PositiveAltitude/BLDC-servo-v1-hardware/bldc_servo_v1.kicad_pcb

## KiCad design bldc_servo_v1.kicad_pcb (2025-04-05)

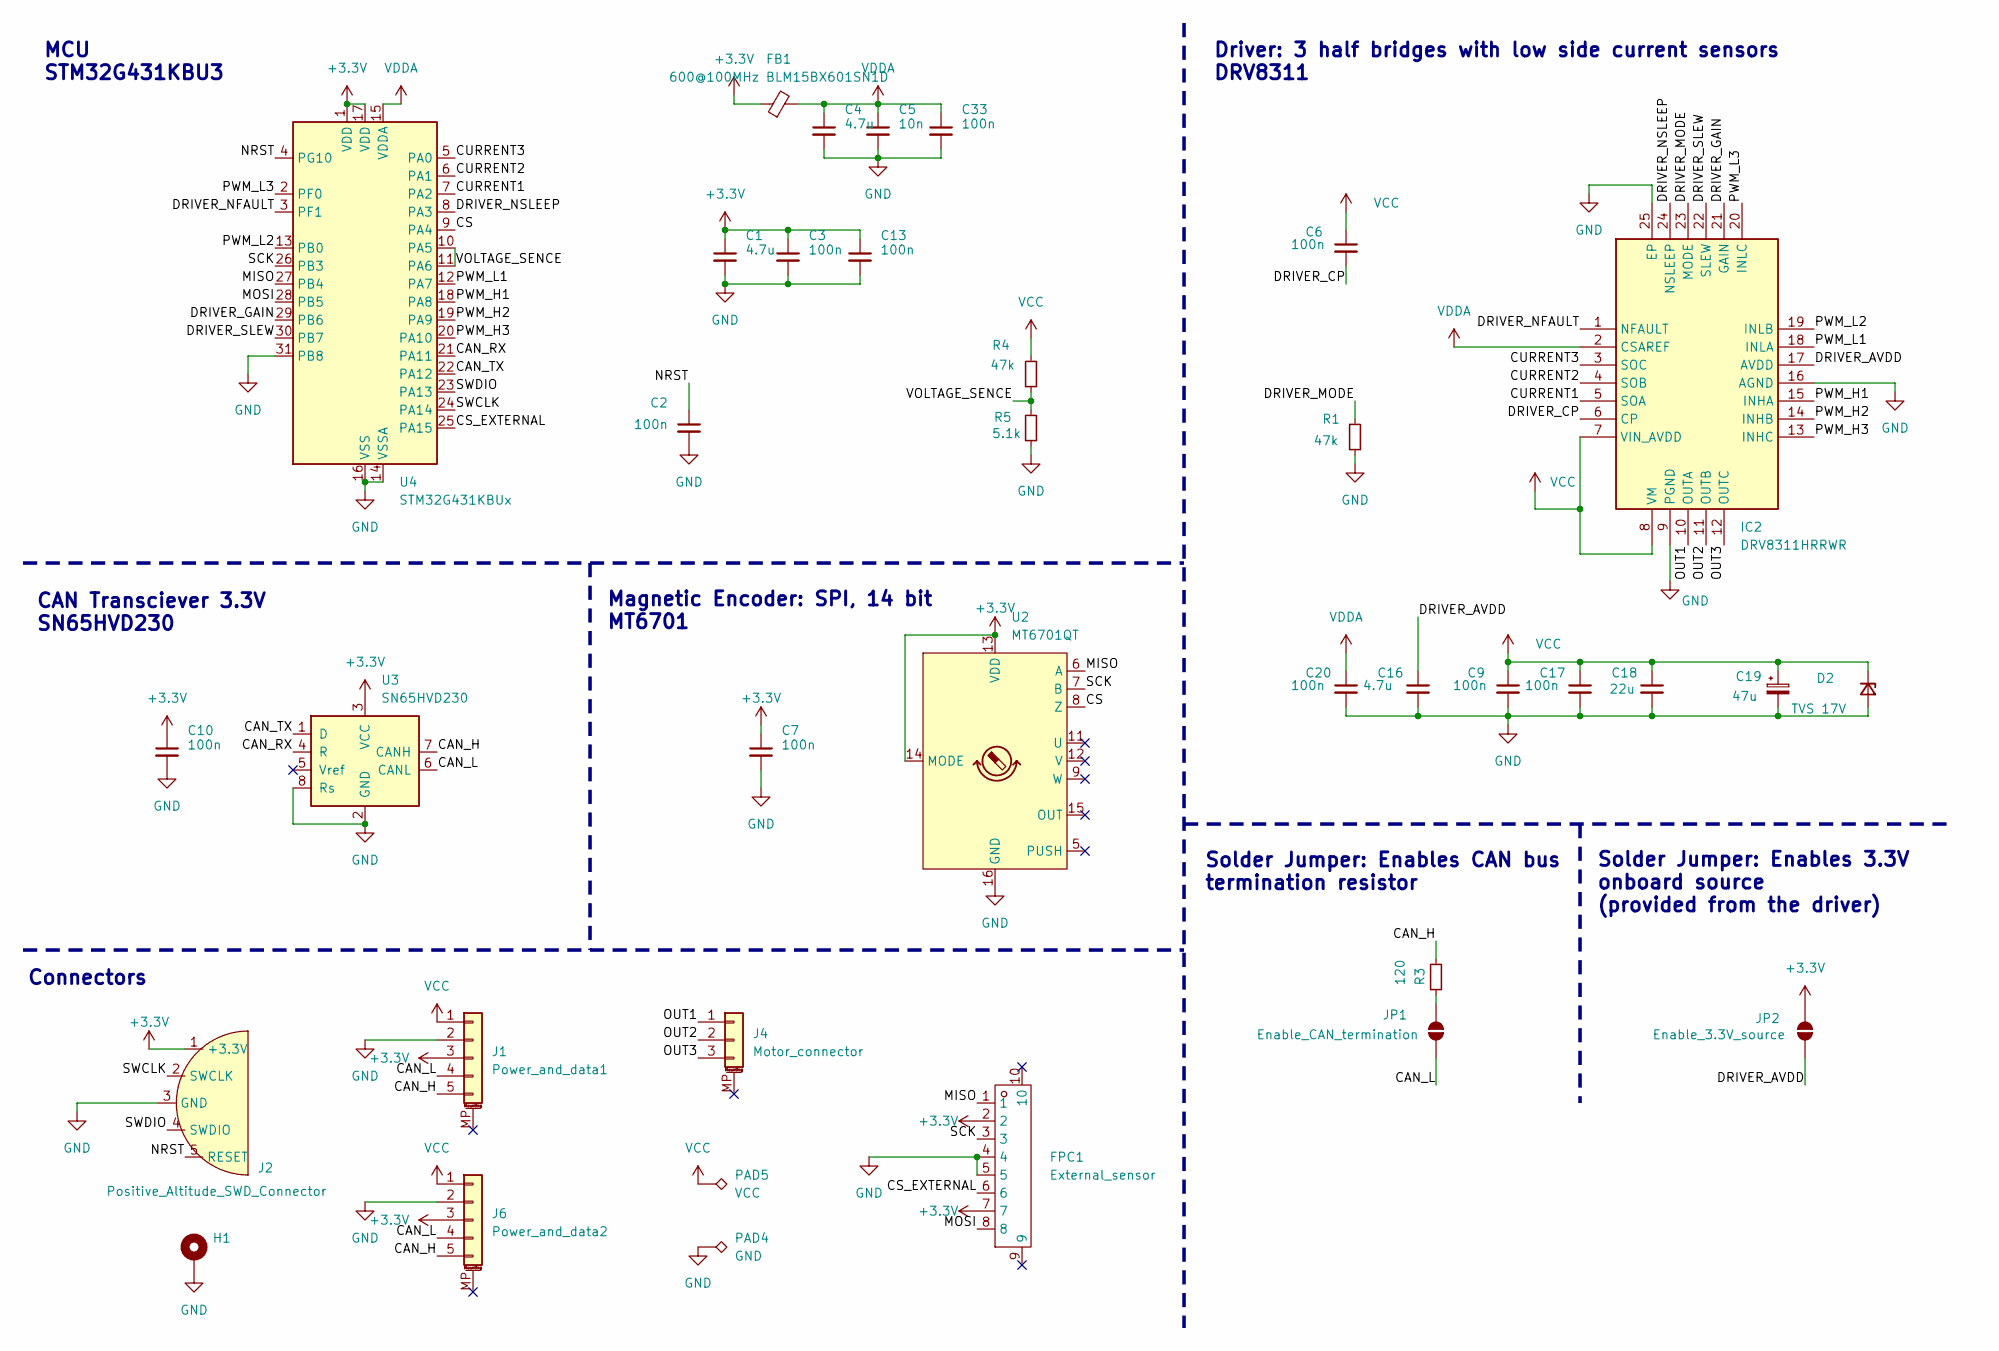
[picture p1: schematic bldc_servo_v1.kicad_sch]

Parts:
C1, C4, C16: 4.7u; C_0603_1608Metric_Pad1.08x0.95mm_HandSolder; LCSC C162274
C2, C3, C6, C7, C9, C10, C13, C17, C20, C33: 100n; C_0402_1005Metric_Pad0.74x0.62mm_HandSolder; LCSC C77020
C5: 10n; C_0402_1005Metric_Pad0.74x0.62mm_HandSolder; LCSC C77019
C18: 22u; C_1210_3225Metric_Pad1.33x2.70mm_HandSolder; LCSC C21397
C19: 47u; CP_Elec_6.3x5.8; LCSC C2161781
D2: TVS 17V; D_SOD-123F; LCSC C353303
FB1: 600@100MHz BLM15BX601SN1D; R_0402_1005Metric_Pad0.72x0.64mm_HandSolder; LCSC C710336
FPC1: External_sensor; FPC-SMD_8P-P0.50_HC-FPC-05-09-8RLTAG; Manufacturer Part HC-FPC-05-09-8RLTAG; LCSC Part Name 翻盖式 双侧触点/上下接 P数:8P 间距:0.5mm
H1: MountingHole_Pad; MountingHole_2.2mm_M2_Pad_TopBottom
IC2: DRV8311HRRWR; DRV8311PRRWR; Mouser Part Number 595-DRV8311HRRWR
J1: Power_and_data1; JST_SH_SM05B-SRSS-TB_1x05-1MP_P1.00mm_Horizontal; LCSC C136657
J2: Positive_Altitude_SWD_Connector
J4: Motor_connector; JST_PH_S3B-PH-SM4-TB_1x03-1MP_P2.00mm_Horizontal; LCSC C265101
J6: Power_and_data2; JST_SH_SM05B-SRSS-TB_1x05-1MP_P1.00mm_Horizontal; LCSC C136657
JP1: Enable_CAN_termination; SolderJumper-2_P1.3mm_Open_RoundedPad1.0x1.5mm
JP2: Enable_3.3V_source; SolderJumper-2_P1.3mm_Open_RoundedPad1.0x1.5mm
PAD4: GND; TestPoint_Pad_1.5x1.5mm
PAD5: VCC; TestPoint_Pad_1.5x1.5mm
R1, R4: 47k; R_0402_1005Metric_Pad0.72x0.64mm_HandSolder; LCSC C93943
R3: 120; R_0402_1005Metric_Pad0.72x0.64mm_HandSolder; LCSC C114758
R5: 5.1k; R_0402_1005Metric_Pad0.72x0.64mm_HandSolder; LCSC C105872
U2: MT6701QT; QFN-16-1EP_3x3mm_P0.5mm_EP1.7x1.7mm; LCSC C2913974
U3: SN65HVD230; SOIC-8_3.9x4.9mm_P1.27mm; LCSC C12084
U4: STM32G431KBUx; QFN-32-1EP_5x5mm_P0.5mm_EP3.45x3.45mm; LCSC C1341901

Connections:
+3.3V: C1.1, C3.1, C7.1, C10.1, C13.1, FB1.1, FPC1.2, FPC1.7, J1.3, J2.1 (+3.3V), J6.3, JP2.2 (B), U2.13 (VDD), U2.14 (MODE), U3.3 (VCC), U4.1 (VDD), U4.17 (VDD)
/CAN_H: J1.5, J6.5, R3.2, U3.7 (CANH)
/CAN_L: J1.4, J6.4, JP1.1 (A), U3.6 (CANL)
/CAN_RX: U3.4 (R), U4.21 (PA11)
/CAN_TX: U3.1 (D), U4.22 (PA12)
/CS: U2.8 (Z), U4.9 (PA4)
/CS_EXTERNAL: FPC1.6, U4.25 (PA15)
/CURRENT1: IC2.5 (SOA), U4.7 (PA2)
/CURRENT2: IC2.4 (SOB), U4.6 (PA1)
/CURRENT3: IC2.3 (SOC), U4.5 (PA0)
/DRIVER_AVDD: C16.1, IC2.17 (AVDD), JP2.1 (A)
/DRIVER_CP: C6.2, IC2.6 (CP)
/DRIVER_GAIN: IC2.21 (GAIN), U4.29 (PB6)
/DRIVER_MODE: IC2.23 (MODE), R1.1
/DRIVER_NFAULT: IC2.1 (NFAULT), U4.3 (PF1)
/DRIVER_NSLEEP: IC2.24 (NSLEEP), U4.8 (PA3)
/DRIVER_SLEW: IC2.22 (SLEW), U4.30 (PB7)
/MISO: FPC1.1, U2.6 (A), U4.27 (PB4)
/MOSI: FPC1.8, U4.28 (PB5)
/NRST: C2.1, J2.5 (RESET), U4.4 (PG10)
/OUT1: IC2.10 (OUTA), J4.1
/OUT2: IC2.11 (OUTB), J4.2
/OUT3: IC2.12 (OUTC), J4.3
/PWM_H1: IC2.15 (INHA), U4.18 (PA8)
/PWM_H2: IC2.14 (INHB), U4.19 (PA9)
/PWM_H3: IC2.13 (INHC), U4.20 (PA10)
/PWM_L1: IC2.18 (INLA), U4.12 (PA7)
/PWM_L2: IC2.19 (INLB), U4.13 (PB0)
/PWM_L3: IC2.20 (INLC), U4.2 (PF0)
/SCK: FPC1.3, U2.7 (B), U4.26 (PB3)
/SWCLK: J2.2 (SWCLK), U4.24 (PA14)
/SWDIO: J2.4 (SWDIO), U4.23 (PA13)
/VOLTAGE_SENCE: R4.1, R5.2, U4.10 (PA5), U4.11 (PA6)
GND: C1.2, C2.2, C3.2, C4.2, C5.2, C7.2, C9.2, C10.2, C13.2, C16.2, C17.2, C18.2, C19.2, C20.2, C33.2, D2.2 (A), FPC1.4, FPC1.5, H1.1, IC2.9 (PGND), IC2.16 (AGND), IC2.25 (EP), J1.2, J2.3 (GND), J6.2, PAD4.1, R1.2, R5.1, U2.16 (GND), U2.17 (GND), U3.2 (GND), U3.8 (Rs), U4.14 (VSSA), U4.16 (VSS), U4.31 (PB8), U4.32 (VSS), U4.33 (VSS)
unnamed: JP1.2 (B), R3.1
VCC: C6.1, C9.1, C17.1, C18.1, C19.1, D2.1 (K), IC2.7 (VIN_AVDD), IC2.8 (VM), J1.1, J6.1, PAD5.1, R4.2
VDDA: C4.1, C5.1, C20.1, C33.1, FB1.2, IC2.2 (CSAREF), U4.15 (VDDA)

Notes on the sheet:
MCU STM32G431KBU3
Solder Jumper: Enables 3.3V onboard source (provided from the driver)
Driver: 3 half bridges with low side current sensors DRV8311
Magnetic Encoder: SPI, 14 bit MT6701
CAN Transciever 3.3V SN65HVD230
Solder Jumper: Enables CAN bus termination resistor
Connectors

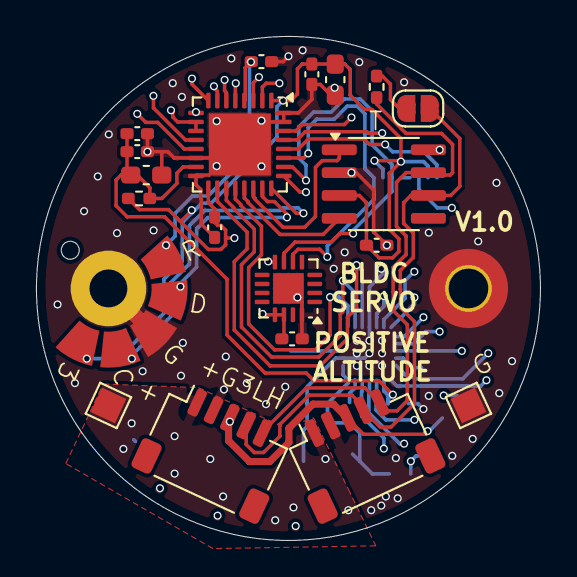
[picture p2: board bldc_servo_v1.kicad_pcb from above]

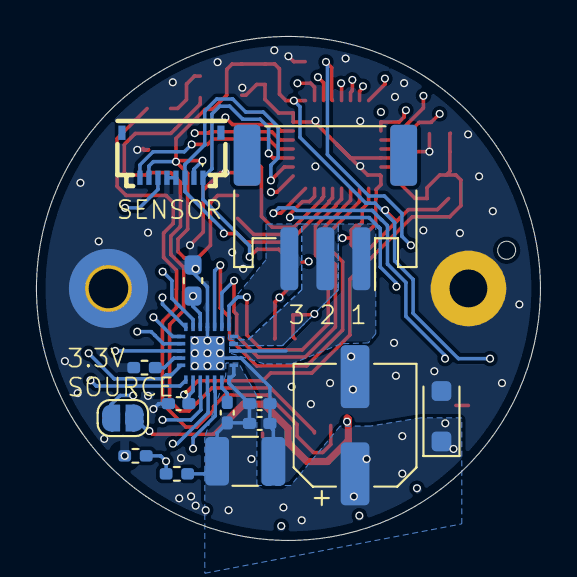
[picture p3: board bldc_servo_v1.kicad_pcb from below]

Board: 6 copper layers, 28.0 x 28.0 mm, 36 parts (15 on the bottom side), 37 nets.
