PositiveAltitude/BLDC-servo-v1-hardware/(commit log)

2025-04-02 6 layer board draft
    [bldc_servo_mini_v1.kicad_pcb, bldc_servo_mini_v1.kicad_sch]
2025-04-03 Almost finished board and pannel
    [bldc_servo_mini_v1-B_Cu.gbr, bldc_servo_mini_v1-B_Mask.gbr, bldc_servo_mini_v1-B_Paste.gbr, bldc_servo_mini_v1-B_Silkscreen.gbr, bldc_servo_mini_v1-Edge_Cuts.gbr, bldc_servo_mini_v1-F_Cu.gbr, bldc_servo_mini_v1-F_Mask.gbr, bldc_servo_mini_v1-F_Paste.gbr]
2025-04-04 Component IDs and cleanup
    [bldc_servo_mini_v1.kicad_pcb, bldc_servo_mini_v1.kicad_sch]
2025-04-05 Upgrading to KiCad 9
    [bldc_servo_mini_v1.kicad_pcb, bldc_servo_mini_v1.kicad_sch]
2025-04-05 Rename project
    [bldc_servo_mini_v1.kicad_pcb, bldc_servo_mini_v1.kicad_sch]
2025-04-05 Fabrication output
    [bldc_servo_v1.kicad_pcb, bldc_servo_v1.kicad_sch, bom.csv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]
2025-04-05 Tooling and fiducials
    [panel-CmtUser.gbr, panel-CuBottom.gbl, panel-CuTop.gtl, panel-EdgeCuts.gm1, panel-MaskBottom.gbs, panel-MaskTop.gts, panel-NPTH-drl_map.gbr, panel-NPTH.drl]
2025-04-05 Small fixes
    [bldc_servo_v1.kicad_pcb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]
2025-04-05 Adjustments to panel, LCSC bom
    [LCSC-bom.csv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]
